UCSD-E4E/TurtleBot/(commit log)

2014-09-25 Implemented all of the drive code. Calibration required!
2014-09-26 Fixed spelling error in documentation.
    [DriveCode.ino]
